PiotrSperka/ESP8266-WebRadio/(threads)

Thread 1 (2015-08-09):

how to?

zajaklis, 2015-08-09:
can you please describe hardware necessary for webplayer.
i already have VS1053 and im not sure which esp8266 is needed for this setup and how wiring is done.
any help?

at the moment i tryed to compile and flash esp8266-01, but for some reason it does not connect to my wifi.
I already changed
sprintf(config->ssid, "myssid");
	sprintf(config->password, "mypass");

PiotrSperka, 2015-08-09:
I'm going to publish schematic in next few days. I'm using ESP-07 module. Player in current version uses only ESP8266, VS1053 and FT232 for UART<->USB translation (programming and debugging). Wiring is done as follows:
VS1053          ESP8266
MISO --------> GPIO12
MOSI --------> GPIO13
SCK ----------> GPIO14
XRST --------> GPIO0
DREQ -------> GPIO5
XCS ---------> GPIO15
XDCS -------> GPIO4

PiotrSperka, 2015-08-09:
After powering up device it should connect to preprogrammed wifi. Then you can open admin panel through web browser (device IP is printed through UART when connection is successful). Moreover, if you want, you can use some UART commands (followed by ENTER key):
wifi.status - connection information
wifi.discon - disconnect wifi
wifi.con("ssid","pass") - connect to wifi
wifi.station - list available wifi networks
cli.start - start playing shoutcast
cli.stop - stop playing shoutcast
cli.port(port_no)
cli.path("path/to/file")
cli.url("some.radio.com")

Closed 2015-08-17.

Thread 3 (2015-11-03):

Additional MCU

confile, 2015-11-03:
What is the Additional MCU used for? What is the correct name? Can I also work without it?

PiotrSperka, 2015-11-03:
Additional MCU will be used in future for user interface (LCD, buttons, etc.), and it will probably be some AVR (ATMega8 maybe).

Closed 2015-11-03.

Thread 8 (2016-04-09):

PDF Schematics

pickeld, 2016-04-09:
can you please provide pdf or fritzing schematics for this project?

karawin, 2016-04-09:
To help you:
From ESP8266_ESP12  to  VS1053
REST
ADC
CH_PD to 3.3v
GPIO16 (a 1KHz output)
GPIO14 to SCK
GPIO12 to MISO
GPIO13 to MOSI

TXD  to uart
RXD from UART
GPIO05 to XDCS
GPIO04 to DREQ
GPIO00 to XRST
GPIO02
GPIO15 to XCS

I made some upgrades to the software at https://github.com/karawin/ESP8266-WebRadio
Can play .m3u and .pls links
can follow moved links
Added a pause (stop) button on the server
etc...

todo:
I am adding a small keyboard with vol+ vol- next and prev station on the adc port.

A cool feature would be to save and restore the links database.

basti79, 2016-05-30:
I build it according to this pinout and I've got a little addition:
For me it was important to add a pull-down resistor from GPIO15 to GND to make the ESP boot correctly.

Apart from that it works like a charm. Many thinks.

Thread 9 (2016-06-18):

PCB and extra ram

karawin, 2016-06-18:
Hi PiotSperka,

I think that there is a mistake on the Eeschema: U4 pin 11 is labelled GPIO1, I think it is GPIO2.

Why not using this one as CS for the ram?
This will let GPIO16 free for an optional led indicator?

Thanks
JP (KaraWin)

PiotrSperka, 2016-06-18:
Hi,

I made these labels based on labels on my module's PCB. I haven't used
that pin, because I had some trouble with driving it. If there was a
mistake on PCB's labels this could be the reason. I need to check that.
If you can drive this pin (GPIO1 or GPIO2), there is no problem using it
as CS for the ram. The only thing to do is to rewire this one pin on PCB
and review extram.c file.

Best regards,
Piotr Sperka

W dniu 18.06.2016 o 14:39, KaraWin pisze:
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

karawin, 2016-06-18:
Thanks for the answer.
I will see with http://www.forward.com.au/pfod/ESP8266/GPIOpins/index.html to test it.
Congratulations for your good work.

karawin, 2016-06-18:
I will try GPIO9 or 10 .....

karawin, 2016-06-18:
That will do the trick.
Strange: the blue led on esp blink according to GPIO2 state.

#define GPIO2	2
void ICACHE_FLASH_ATTR
gpio2_output_conf(void)
{
	PIN_DIR_OUTPUT = (1<<GPIO2);
}

void ICACHE_FLASH_ATTR
gpio2_output_set(uint8 value)
{
	if(value == 0) PIN_OUT_CLEAR = (1<<GPIO2);
	else PIN_OUT_SET = (1<<GPIO2);
}

karawin, 2016-06-18:
Finally, i keep the test task and the blue and external led blink because i like it ;-) but i move it to GPIO2.
And GPIO16 for the cs of the external ram.

karawin, 2016-06-18:
According to https://github.com/esp8266/esp8266-wiki/wiki/gpio-registers
No need to |=  in
ICACHE_FLASH_ATTR void ControlReset(uint8_t State){
	if(State) PIN_OUT_CLEAR = (1<<RST_PIN);
	else PIN_OUT_SET = (1<<RST_PIN);
}

ICACHE_FLASH_ATTR void SCI_ChipSelect(uint8_t State){
	if(State) PIN_OUT_CLEAR = (1<<CS_PIN);
	else PIN_OUT_SET = (1<<CS_PIN);
}

ICACHE_FLASH_ATTR void SDI_ChipSelect(uint8_t State){
	if(State) PIN_OUT_CLEAR = (1<<XDCS_PIN);
	else PIN_OUT_SET = (1<<XDCS_PIN);
}
