PiotrSperka/ESP8266-WebRadio/Hardware/KiCAD/Main/ESP8266-WebRadio.kicad_pcb

## KiCad design Hardware/KiCAD/Main/ESP8266-WebRadio.kicad_pcb (2016-04-17)

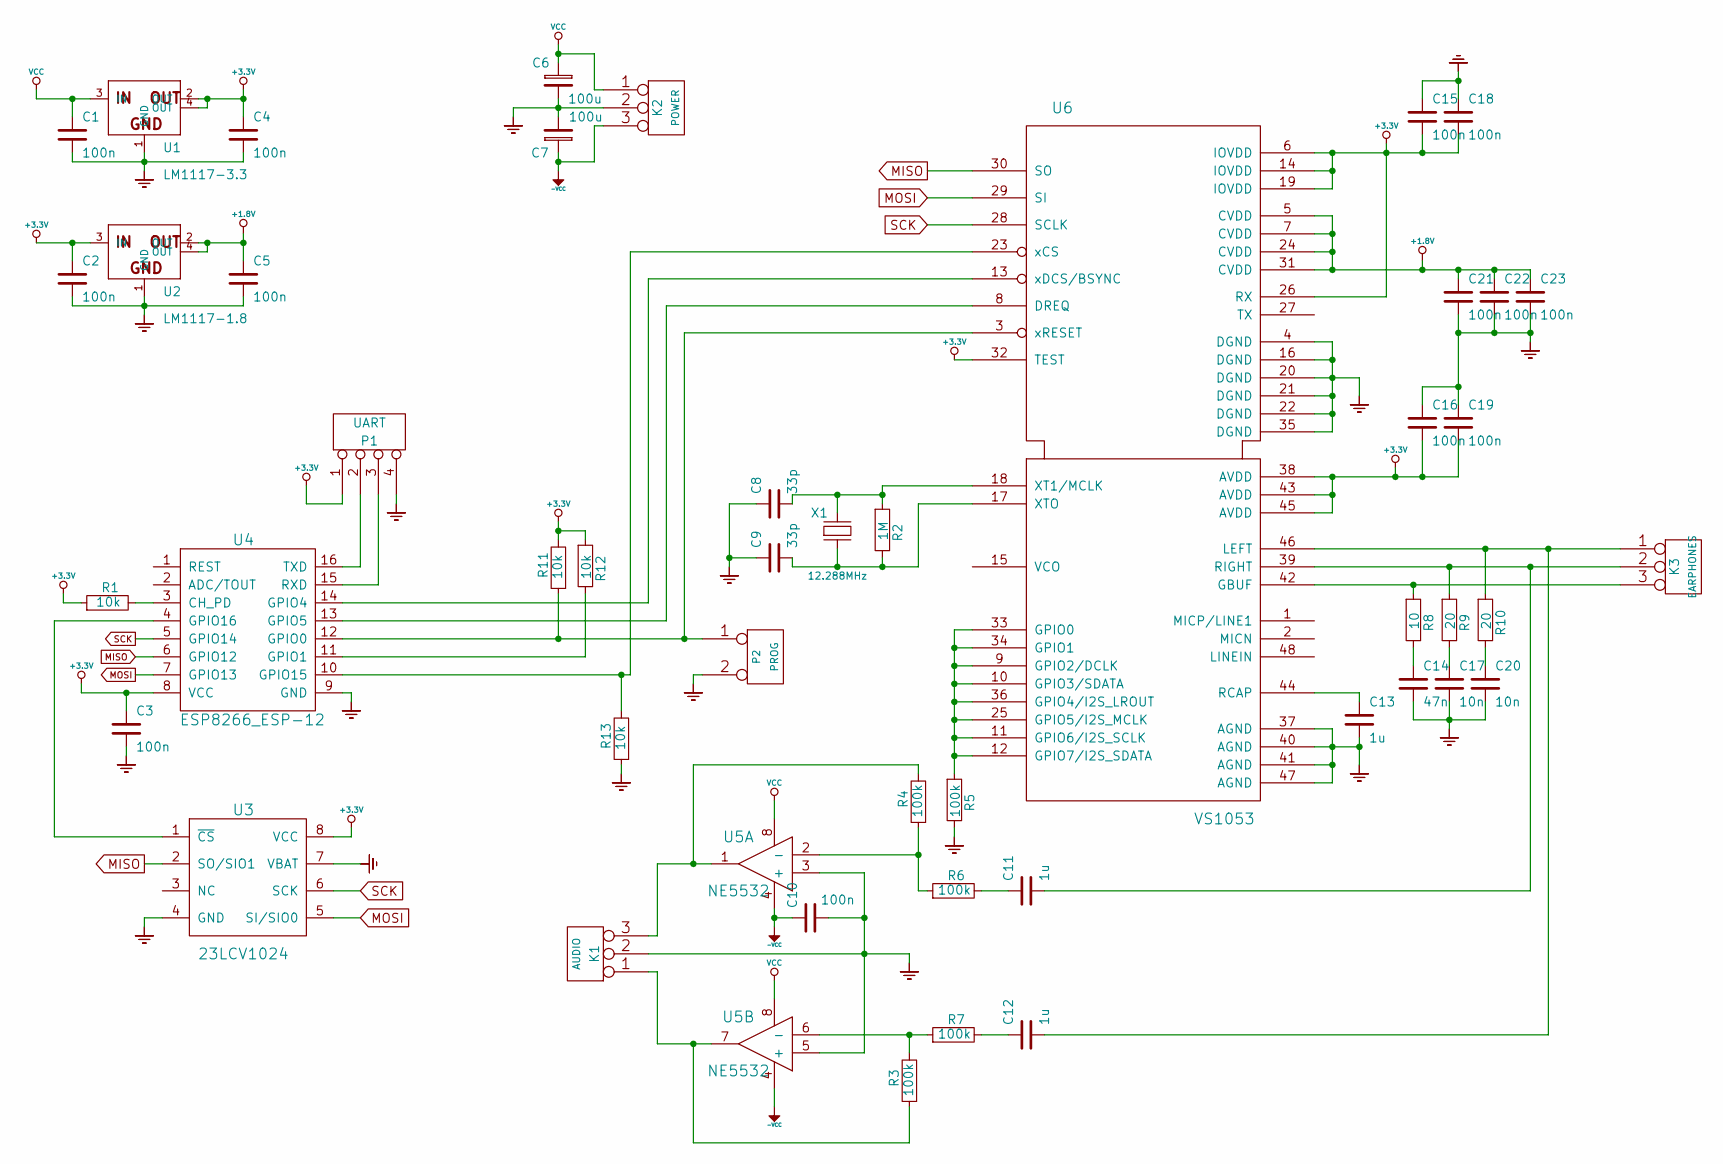
[picture p1: schematic ESP8266-WebRadio.sch, ESP8266 SHOUTcast player]

Parts:
C1, C2, C3, C4, C5, C10, C15, C16, C18, C19, C21, C22, C23: 100n
C6, C7: 100u
C8, C9: 33p
C11, C12, C13: 1u
C14: 47n
C17, C20: 10n
K1: AUDIO
K2: POWER
K3: EARPHONES
P1: UART
P2: PROG
R1, R11, R12, R13: 10k
R2: 1M
R3, R4, R5, R6, R7: 100k
R8: 10
R9, R10: 20
U1: LM1117-3.3
U2: LM1117-1.8
U3: 23LCV1024
U4: ESP8266_ESP-12
U5: NE5532
U6: VS1053
X1: 12.288MHz

Connections:
+1.8V: C5.1, C21.1, C22.1, C23.1, U2.2 (OUT), U2.4 (OUT), U6.5 (CVDD), U6.7 (CVDD), U6.24 (CVDD), U6.31 (CVDD)
+3.3V: C2.1, C3.1, C4.1, C15.2, C16.2, C18.2, C19.2, P1.1, R1.1, R11.2, R12.1, U1.2 (OUT), U1.4 (OUT), U2.3 (IN), U3.8 (VCC), U4.8 (VCC), U6.6 (IOVDD), U6.14 (IOVDD), U6.19 (IOVDD), U6.26 (RX), U6.32 (TEST), U6.38 (AVDD), U6.43 (AVDD), U6.45 (AVDD)
-6V: C7.1, C10.1, K2.3, U5.4
GND: C1.2, C2.2, C3.2, C4.2, C5.2, C6.2, C7.2, C8.1, C9.1, C10.2, C13.2, C14.2, C15.1, C16.1, C17.2, C18.1, C19.1, C20.2, C21.2, C22.2, C23.2, K1.2 (PM), K2.2 (PM), P1.4, P2.2 (PM), R5.2, R13.1, U1.1 (GND), U2.1 (GND), U3.4 (GND), U3.7 (VBAT), U4.9 (GND), U5.3 (+), U5.5 (+), U6.4 (DGND), U6.16 (DGND), U6.20 (DGND), U6.21 (DGND), U6.22 (DGND), U6.35 (DGND), U6.37 (AGND), U6.40 (AGND), U6.41 (AGND), U6.47 (AGND); also elsewhere on the board
MISO: U3.2 (SO/SIO1), U4.6 (GPIO12), U6.30 (SO)
MOSI: U3.5 (SI/SIO0), U4.7 (GPIO13), U6.29 (SI)
unnamed: C8.2, R2.1, U6.18 (XT1/MCLK), X1.2
unnamed: C9.2, R2.2, U6.17 (XTO), X1.1
unnamed: R5.1, U6.9 (GPIO2/DCLK), U6.10 (GPIO3/SDATA), U6.11 (GPIO6/I2S_SCLK), U6.12 (GPIO7/I2S_SDATA), U6.25 (GPIO5/I2S_MCLK), U6.33 (GPIO0), U6.34 (GPIO1), U6.36 (GPIO4/I2S_LROUT)
unnamed: C13.1, U6.44 (RCAP)
unnamed: C12.1, R7.2
unnamed: C11.1, R6.2
unnamed: R4.1, R6.1, U5.2 (-)
unnamed: R3.2, R7.1, U5.6 (-)
unnamed: K1.1, R3.1, U5.7
unnamed: K1.3, R4.2, U5.1
unnamed: R12.2, U4.11 (GPIO1)
unnamed: P1.2, U4.16 (TXD)
unnamed: P1.3, U4.15 (RXD)
unnamed: C17.1, R9.2
unnamed: K3.3, R8.1, U6.42 (GBUF)
unnamed: C11.2, K3.2 (PM), R9.1, U6.39 (RIGHT)
unnamed: C12.2, K3.1, R10.1, U6.46 (LEFT)
unnamed: C14.1, R8.2
unnamed: C20.1, R10.2
unnamed: U3.1 (~CS), U4.4 (GPIO16)
unnamed: P2.1, R11.1, U4.12 (GPIO0), U6.3 (xRESET)
unnamed: R1.2, U4.3 (CH_PD)
unnamed: R13.2, U4.10 (GPIO15), U6.23 (xCS)
unnamed: U4.14 (GPIO4), U6.13 (xDCS/BSYNC)
unnamed: U4.13 (GPIO5), U6.8 (DREQ)
SCK: U3.6 (SCK), U4.5 (GPIO14), U6.28 (SCLK)
VCC: C1.1, C6.1, K2.1, U1.3 (IN), U5.8

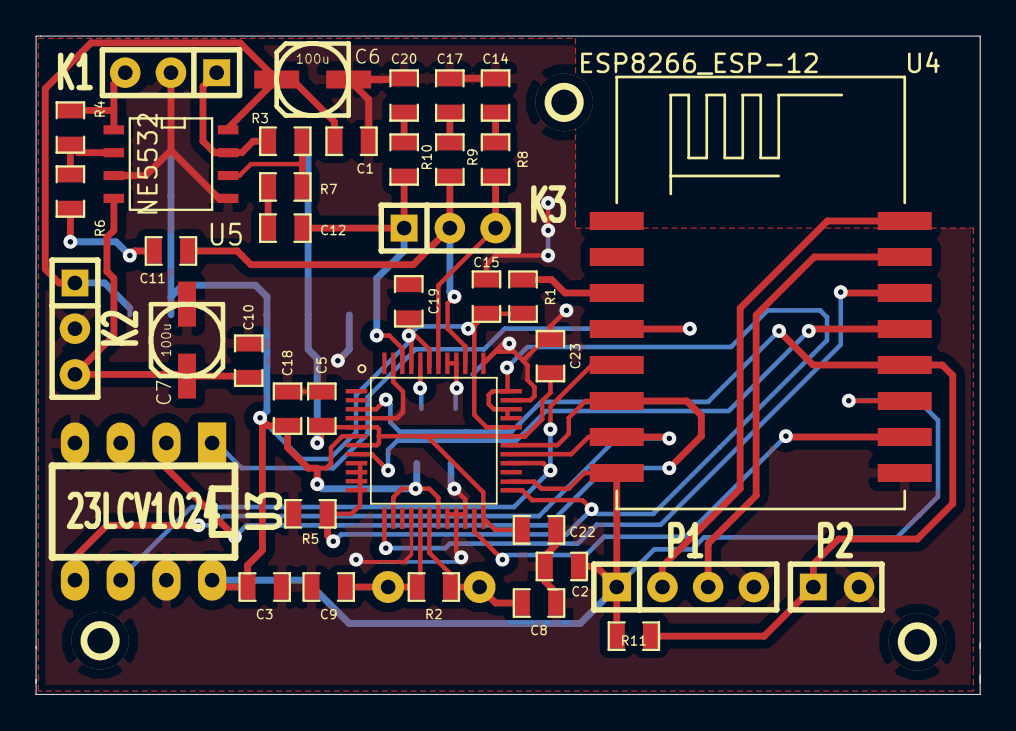
[picture p2: board ESP8266-WebRadio.kicad_pcb from above]

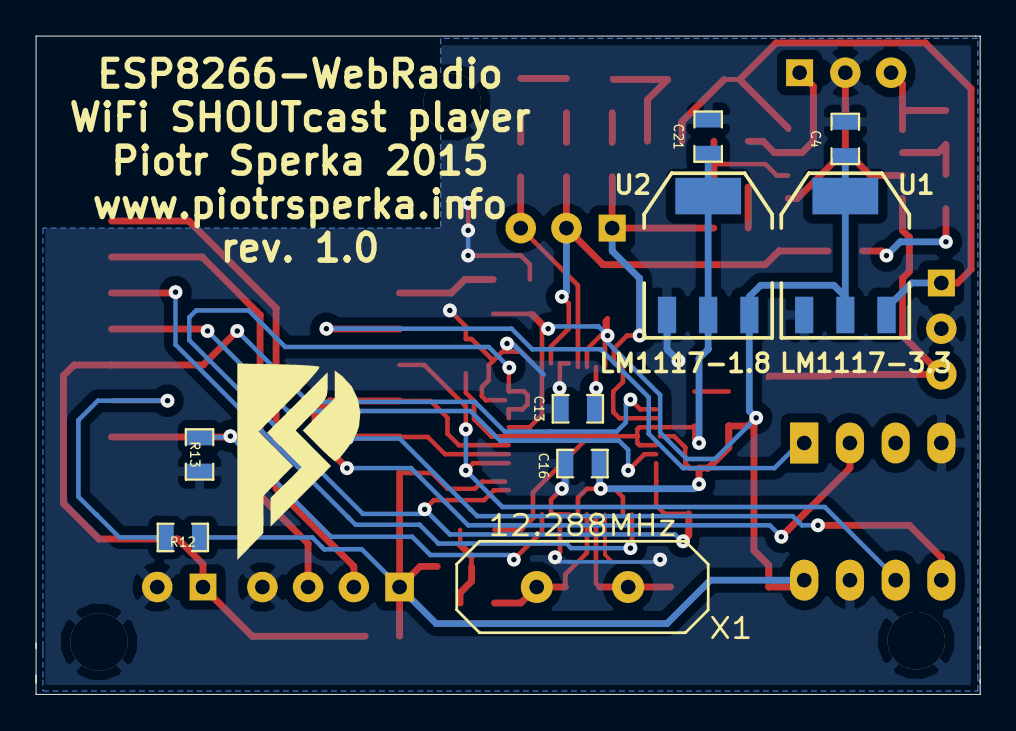
[picture p3: board ESP8266-WebRadio.kicad_pcb from below]

Board: 2 copper layers, 52.5 x 36.6 mm, 51 parts (9 on the bottom side), 33 nets.

Other parts of the board:
1PIN, 1PIN#2: P***; 1pin
VAL: REF; Logo

Their connections:
GND: 1PIN.1, 1PIN#2.1; also elsewhere on the board
