PiotrSperka/ESP8266-WebRadio/ESP8266-Firmware/app/include/buffer.h

/*
 * Copyright 2016 Piotr Sperka (http://www.piotrsperka.info)
*/
#ifndef __BUFFER_H__
#define __BUFFER_H__

#include "c_types.h"

// Comment line below if you don't want to use external SRAM
#define USE_EXTERNAL_SRAM 1

#ifndef USE_EXTERNAL_SRAM
	#define BUFFER_SIZE 12960
#else // If you use external SRAM with different size, change it below
	#define BUFFER_SIZE 131072
#endif

uint32_t getBufferFree();
uint32_t getBufferFilled();
uint32_t bufferWrite(uint8_t *data, uint32_t size);
uint32_t bufferRead(uint8_t *data, uint32_t size);
void bufferReset();

#endif
