PiotrSperka/ESP8266-WebRadio/ESP8266-Firmware/app/user/buffer.c

/*
 * Copyright 2016 Piotr Sperka (http://www.piotrsperka.info)
*/

#include "buffer.h"
#include "esp_common.h"
#include "extram.h"

#ifndef USE_EXTERNAL_SRAM
	uint8_t buffer[BUFFER_SIZE];
#endif

uint32_t wptr = 0;
uint32_t rptr = 0;
uint8_t bempty = 1;

ICACHE_FLASH_ATTR uint32_t getBufferFree() {
	if(wptr > rptr ) return BUFFER_SIZE - wptr + rptr;
	else if(wptr < rptr) return rptr - wptr;
	else if(bempty) return BUFFER_SIZE; else return 0;
}

ICACHE_FLASH_ATTR uint32_t getBufferFilled() {
	return BUFFER_SIZE - getBufferFree();
}

ICACHE_FLASH_ATTR uint32_t bufferWrite(uint8_t *data, uint32_t size) {
	#ifndef USE_EXTERNAL_SRAM
		uint32_t i;
		for(i=0; i<size; i++) {
			if(getBufferFree() == 0) { return i;}
			buffer[wptr++] = data[i];
			if(bempty) bempty = 0;
			if(wptr == BUFFER_SIZE) wptr = 0;
		}
	#else
		if(getBufferFree() < size) size = getBufferFree();
		extramWrite(size, wptr, data);
		wptr += size;
		if(bempty) bempty = 0;
		if(wptr >= BUFFER_SIZE) wptr -= BUFFER_SIZE;
	#endif
	return size;
}

ICACHE_FLASH_ATTR uint32_t bufferRead(uint8_t *data, uint32_t size) {
	uint32_t i = 0;
	uint32_t bf = getBufferFilled();
	if(size > bf) size = bf;
	#ifndef USE_EXTERNAL_SRAM
		for (i = 0; i < size; i++) {
			if(bf == 0) { return i;}
			data[i] = buffer[rptr++];
			if(rptr == BUFFER_SIZE) rptr = 0;
			if(rptr == wptr) bempty = 1;
		}
	#else
		extramRead(size, rptr, data);
		rptr += size;
		if(rptr >= BUFFER_SIZE) rptr -= BUFFER_SIZE;
		if(rptr == wptr) bempty = 1;
	#endif
	return size;
}

ICACHE_FLASH_ATTR void bufferReset() {
	wptr = 0;
	rptr = 0;
	bempty = 1;
}
