PiotrSperka/ESP8266-WebRadio/(commit log)

2015-03-06 Added support for incoming uart messages and protorype of command parser
2015-03-10 Simple UART command parser (WiFi connection) Simple HTTP server is hosting sample webpage
2015-03-23 Added HTTP client UART output Added unclean sketch of STM32 firmware for basic testing purposes Improved HTTP server configuration
2015-08-07 Simple sketch of VS1053 driver Simple and not finished version of webclient
2015-08-07 DNS Resolver Webclient uses functions for setting URL, path and port A little bit of webclient and VS1053 code cleanup
    [user_main.c, vs1053.c, webclient.c]
2015-08-08 Improvements of webserver and webinterface DNS resolver
    [user_main.c, webclient.c]
2015-08-08 Webserver uses sockets - improved stability
    [user_main.c, webclient.c]
2015-08-15 Added schematic of main board
    [ESP8266-WebRadio.sch]
2015-08-17 Added schematic and PCB of main board
    [ESP8266-WebRadio.kicad_pcb, ESP8266-WebRadio.sch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]
2015-08-23 Development of flash eeprom functions, GPIO16, webinterface changes, webclient is using sockets.
2015-09-01 Added pullups in schematic and PCB
    [ESP8266-WebRadio.kicad_pcb, ESP8266-WebRadio.sch, UI-Bridge.sch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]
2016-04-16 Merged with karawin's fork Added metadata parsing
    [UI-Bridge.sch]
2016-04-17 Added missing KiCad libraries Added missing .a files
    [ESP8266-WebRadio.kicad_pcb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]
2016-06-17 Merged with karawin's fork
    [Selector.sch, UI-Bridge.sch]
